nathancharlesjones/STM32F103C8T6-breakout-board/Supporting-documentation/STM32F103C8T6-breakout-board_power-section-graphic.pdf

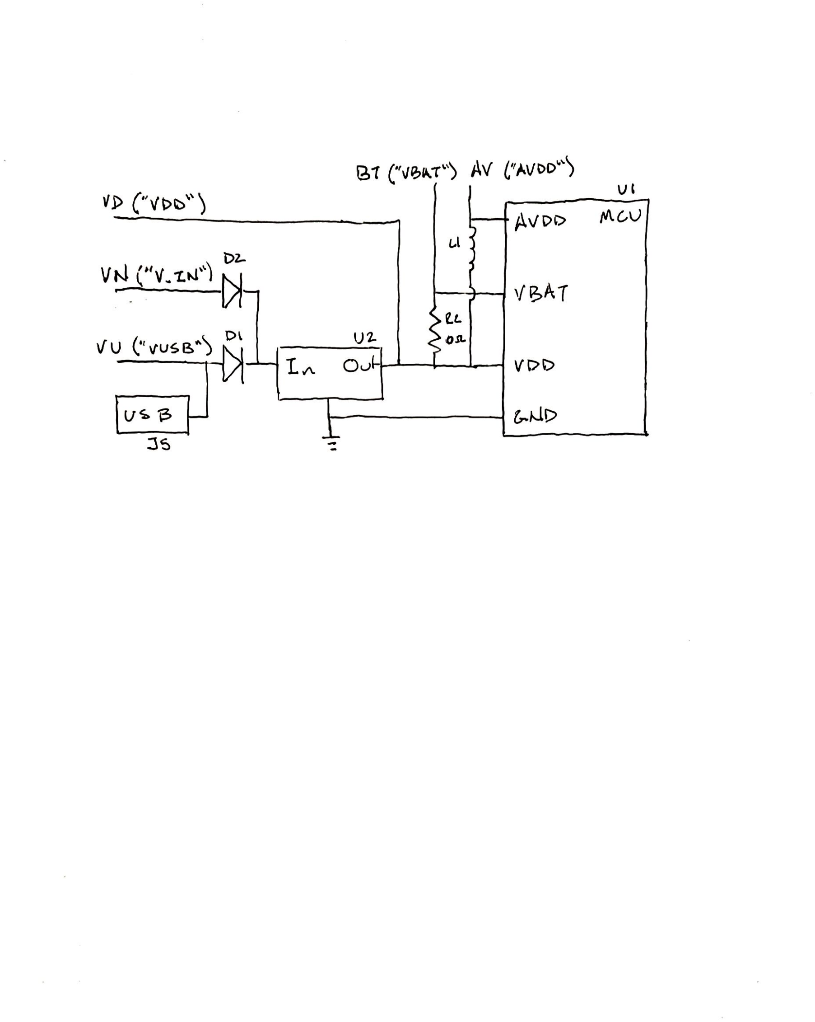
[picture p3: page 1]

B7 ("VBA7") AV ("AVDOWS
VD (“VDO")
UI
MCU
AVDD
LI
D2
VN ("V. IN“)
VBAT
.22
DI
OS
VU ("VUSB S
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
