nathancharlesjones/STM32F103C8T6-breakout-board/Supporting-documentation/Configuration-price-comparison-with-various-qty.xlsx

Sheet: Configurations
 | Minimum F031 | Minimum F302 | Minimum F103 | Standard F031 | Standard F302 | Standard F103 | Full F031 | Full F302 | Full F103
PCB | $5.00 | $5.00 | $5.00 | $5.00 | $5.00 | $5.00 | $5.00 | $5.00 | $5.00
Setup | $7.00 | $7.00 | $7.00 | $7.00 | $7.00 | $7.00 | $7.00 | $7.00 | $7.00
Stencil | $1.50 | $1.50 | $1.50 | $1.50 | $1.50 | $1.50 | $1.50 | $1.50 | $1.50
MCU | $9.73 | $30.02 | $56.21 | $9.73 | $30.02 | $56.21 | $9.73 | $30.02 | $56.21
MCU extended | $3.00 | $3.00 | $0.00 | $3.00 | $3.00 | $0.00 | $3.00 | $3.00 | $0.00
Other components | $2.32 | $2.32 | $2.32 | $10.57 | $10.58 | $10.58 | $15.29 | $15.29 | $15.30
Other extended | $3.00 | $3.00 | $3.00 | $6.00 | $6.00 | $6.00 | $9.00 | $9.00 | $9.00
Assembly | $1.60 | $1.60 | $1.60 | $2.12 | $2.12 | $2.12 | $2.10 | $2.10 | $2.10
Sum | $33.15 | $53.44 | $76.63 | $44.92 | $65.22 | $88.41 | $52.62 | $72.91 | $96.11
Price/unit | $3.32 | $5.34 | $7.66 | $4.49 | $6.52 | $8.84 | $5.26 | $7.29 | $9.61
MCU | $1.27 | $3.30 | $5.62 | $1.27 | $3.30 | $5.62 | $1.27 | $3.30 | $5.62
Everything else | $2.04 | $2.04 | $2.04 | $3.22 | $3.22 | $3.22 | $3.99 | $3.99 | $3.99

Sheet: Minimum
 | Minimum F103, Qty: 10 | Minimum F103, Qty: 15 | Minimum F103, Qty: 20 | Minimum F103, Qty: 25 | Minimum F103, Qty: 30 | Minimum F103, Qty: 50
PCB | $5.00 | $5.50 | $6.00 | $6.50 | $7.00 | $12.30
Setup | $7.00 | $7.00 | $7.00 | $7.00 | $7.00 | $7.00
Stencil | $1.50 | $1.50 | $1.50 | $1.50 | $1.50 | $1.50
MCU | $56.21 | $84.21 | $112.28 | $140.34 | $151.45 | $252.42
MCU extended | $0.00 | $0.00 | $0.00 | $0.00 | $0.00 | $0.00
Other components | $2.32 | $2.56 | $3.01 | $3.46 | $3.91 | $6.13
Other extended | $3.00 | $3.00 | $3.00 | $3.00 | $3.00 | $3.00
Assembly | $1.60 | $2.08 | $2.62 | $3.16 | $3.70 | $6.04
Sum | $76.63 | $105.85 | $135.41 | $164.96 | $177.56 | $288.39
Price/unit | $7.66 | $7.06 | $6.77 | $6.60 | $5.92 | $5.77
MCU | $5.62 | $5.61 | $5.61 | $5.61 | $5.05 | $5.05
Everything else | $2.04 | $1.44 | $1.16 | $0.98 | $0.87 | $0.72

Sheet: Standard_no_HSE
 | Standard F103, Qty: 10 | Standard F103, Qty: 15 | Standard F103, Qty: 20 | Standard F103, Qty: 25 | Standard F103, Qty: 30 | Standard F103, Qty: 50
PCB | $5.00 | $5.50 | $6.00 | $6.50 | $7.00 | $12.30
Setup | $7.00 | $7.00 | $7.00 | $7.00 | $7.00 | $7.00
Stencil | $1.50 | $1.50 | $1.50 | $1.50 | $1.50 | $1.50
MCU | $56.14 | $84.21 | $112.28 | $140.34 | $151.45 | $252.42
MCU extended | $0.00 | $0.00 | $0.00 | $0.00 | $0.00 | $0.00
Other components | $4.62 | $5.82 | $7.41 | $9.00 | $10.61 | $17.15
Other extended | $3.00 | $3.00 | $3.00 | $3.00 | $3.00 | $3.00
Assembly | $1.91 | $2.46 | $3.13 | $3.81 | $4.48 | $7.30
Sum | $79.17 | $109.49 | $140.32 | $171.16 | $185.04 | $300.67
Price/unit | $7.92 | $7.30 | $7.02 | $6.85 | $6.17 | $6.01
MCU | $5.61 | $5.61 | $5.61 | $5.61 | $5.05 | $5.05
Everything else | $2.30 | $1.69 | $1.40 | $1.23 | $1.12 | $0.97

Sheet: Standard_with_HSE
 | Standard F103, Qty: 10 | Standard F103, Qty: 15 | Standard F103, Qty: 20 | Standard F103, Qty: 25 | Standard F103, Qty: 30 | Standard F103, Qty: 50
PCB | $5.00 | $5.50 | $6.00 | $6.50 | $7.00 | $12.30
Setup | $7.00 | $7.00 | $7.00 | $7.00 | $7.00 | $7.00
Stencil | $1.50 | $1.50 | $1.50 | $1.50 | $1.50 | $1.50
MCU | $56.21 | $84.21 | $112.28 | $140.34 | $151.45 | $252.42
MCU extended | $0.00 | $0.00 | $0.00 | $0.00 | $0.00 | $0.00
Other components | $10.58 | $14.45 | $18.73 | $23.02 | $22.78 | $37.17
Other extended | $6.00 | $6.00 | $6.00 | $6.00 | $6.00 | $6.00
Assembly | $2.12 | $2.72 | $3.44 | $4.16 | $4.88 | $7.94
Sum | $88.41 | $121.38 | $154.95 | $188.52 | $200.61 | $324.33
Price/unit | $8.84 | $8.09 | $7.75 | $7.54 | $6.69 | $6.49
MCU | $5.62 | $5.61 | $5.61 | $5.61 | $5.05 | $5.05
Everything else | $3.22 | $2.48 | $2.13 | $1.93 | $1.64 | $1.44

Sheet: Full
 | Standard F103, Qty: 10 | Standard F103, Qty: 15 | Standard F103, Qty: 20 | Standard F103, Qty: 25 | Standard F103, Qty: 30 | Standard F103, Qty: 50
PCB | $5.00 | $5.50 | $6.00 | $6.50 | $7.00 | $12.30
Setup | $7.00 | $7.00 | $7.00 | $7.00 | $7.00 | $7.00
Stencil | $1.50 | $1.50 | $1.50 | $1.50 | $1.50 | $1.50
MCU | $56.21 | $84.21 | $112.28 | $140.34 | $151.45 | $252.42
MCU extended | $0.00 | $0.00 | $0.00 | $0.00 | $0.00 | $0.00
Other components | $15.30 | $21.33 | $27.78 | $34.22 | $32.51 | $53.18
Other extended | $9.00 | $9.00 | $9.00 | $9.00 | $9.00 | $9.00
Assembly | $2.10 | $2.74 | $3.50 | $4.27 | $5.03 | $8.21
Sum | $96.11 | $131.28 | $167.06 | $202.84 | $213.49 | $343.61
Price/unit | $9.61 | $8.75 | $8.35 | $8.11 | $7.12 | $6.87
MCU | $5.62 | $5.61 | $5.61 | $5.61 | $5.05 | $5.05
Everything else | $3.99 | $3.14 | $2.74 | $2.50 | $2.07 | $1.82
