nathancharlesjones/STM32F103C8T6-breakout-board/Supporting-documentation/_todo.md

# v1

- [x] What's the pinout for the J-Link connector? -> Not compatible with 20-pin JTAG
  - [x] Is SWD reset connected to NRST or JTRST? -> NRST
    - Pin 10 on 10-pin connector (nRST) is the same as Pin 15 on 20-pin connector (RST or nSRST) and connects to NRST on STM32 (pin 7)
    - Pin 9 on 10-pin connector (NC) is the same as Pin 3 on 20-pin connector (TRST) and connects to JTRST on STM32 (PB4; pin 40)
    - Compare Figure 12 in Hardware Guide with Segger [6-pin](https://www.segger.com/products/debug-probes/j-link/accessories/adapters/6-pin-needle-adapter/) and [10-pin adapters](https://www.segger.com/products/debug-probes/j-link/accessories/adapters/10-pin-needle-adapter/)
    - See also the Tag Connect [TC2050-ARM2010 ARM 20-pin to TC2050 Adapter datasheet](https://www.tag-connect.com/wp-content/uploads/bsk-pdf-manager/TC2050-ARM2010_18.pdf)
- [x] Tie VDDA to VDD?
- [x] Pick new 32kHz osc -> LCSC part #C32346
- [x] Check "Blue Pill" schematic
  - [x] Compare oscillator circuit
    - HSE
      - [x] Change C1/C2 to 30 pF
      - [x] What's R_EXT? Change to 663R?
    - LSE
      - [x] Change C1/C2 to 15 pF
    - [x] Check oscillator circuits
  - [x] Compare reset circuit -> Check for 100nF capacitance
  - [x] Check USB circuit -> Add 1.5K PU resistor on DP line (see AN4879)
- [x] Add USB connector
- [x] Finish adding power capacitors
- [x] Compare SWD connector to SOICBites/Debug Edge -> Use Debug Edge
  - Option 1: Normal 10-pin connector
    - ~$0.50/unit
    - Large footprint (200 x 500 mil)
  - Option 2: Right-angle 10-pin connector
    - ~$0.50/unit
    - Small footprint (150 x 250 mil)
    - Connector should be placed on PCB edge, with no other connectors for another 125 mil on either side
  - Option 3: SOICBites
    - $15 (one-time cost)
    - Small footprint
    - Must be placed on PCB edge; requires overhang
    - Requires hacking the SOIC connector and somehow connecting it to the J-Link
  - Option 4: Debug edge
    - ~$5 (one-time cost)
    - Large footprint (200 x 400 mil)
    - Must be placed on PCB edge; requires overhang
    - Requires building my own adapter board
    - May require building my own Eagle part (Octopart seems to be missing board outline)
    - Chamfering recommended (but possibly [not available from JLCPCB on boards <5cmx5cm](https://jlcpcb.com/quote/pcbOrderFaq/Gold%20Fingers)), though not required (according to Scott/@tannewt)
- [x] Add JLCPCB rules
- [x] Switch to 0402 resistors/capacitors
- [x] Add .gitignore
- [x] Add VUSB
  - Regulator power not needed if powering the MCU from VIN_2.0-3.6V
  - USB and VIN_5-30V need to be diode-protected, since I (may) want to have both connected at the same time. Doesn't matter which is higher, since they're both getting regulated down to 3.3V.
  - Change "VIN_2.0-3.6V" to "VDD"
  - Remove D1/D2 and install jumper; allows developer to decide whether to power the MCU from the "VDD" pin or from the regulator
  - Add "VUSB"; allows developer to power other parts of their circuit from USB.
- [x] Change 0R resistors to cut pads? -> Nah, at $0.002/resistor, it's actually easier to put down a 0R resistor than to ask someone to cut a trace
- [x] Add notch for Debug Edge
- [x] Change voltage regulator
- [x] Change Debug edge pins
- [x] Add LCSC part numbers to components
- [x] Add sections and numbers to schematic
- [x] Finish silkscreen
  - [x] Update component numbers
  - [x] Double check URL
- [x] Change crystals for oscillators
  - [x] Use wider voltage range? -> Nah
- [x] Add folder for special library parts: AVX, USB
- [x] New power arrangement?
- [x] Check USB lines
  - [x] Length match
- [x] Check edge alignment of USB connector/Debug-edge
- [x] Extend Debug edge indentation? -> Nah
- [x] Check hardware layout for STM32F302CBT6
  - [x] Other possibilities: STM32L151C8T6, STM32L052C8T6
- [x] Update LCSC part number for U1 on schematic
- [x] Order
  - [x] Include Q2?
- [x] Update README
  - [x] Get PCB screenshots
- [x] Add R4/6 to CPL
- [x] Check that extra components on CPL are just ignored
- [x] Reduce CPL files to one
- [x] Add Debug Edge README to 6P repo
- [x] Fix clearance issue
  - [x] Update protoboard as well
- [ ] Test!
  - [x] ST-Link
  - [x] J-link
  - [x] Debug Edge
  - [x] Bootloader, J5
  - [x] Bootloader, "USB breakout", Female headers
  - [ ] USB serial, J5
  - [ ] USB serial, "USB breakout", Female headers
- [x] Double-check pin-compatible MCUs (CubeMX lies!!!)
- [x] Update protoboard
  - [x] Add new design block
  - [x] Move J5/J3
  - [x] Check silkscreen
  - [x] Update images
- [x] Double-check compact board rules and silkscreen text
- [x] Find new 3.3V/5V regulators (higher input voltage)?
- [x] Order
  - [x] Follow up with JLCPCB about slotted holes
- [x] Make pinout diagram
- [x] Make power configuration diagram
- [x] Update bom/cpl files
- [x] Add ordering notes (polarity, slot, slotted holes)
- [x] Add editing notes (custom parts)
- [x] Update libraries folder
- [x] Add design block
- [x] Reword the "What is it?" section
- [x] Add ToC
- [x] Add "0R" to R2 in power section graphic
- [x] Change 0402 to tighter 0402
- [x] Check if 1.0mm slot will work
- [x] Update slot to 1.0mm? -> Not unless I have to. Wiggle room is 0mm under worst-case conditions.
- [x] Update things with new gerbers
  - [x] Take new screenshots
    - [x] Top screenshot
    - [x] Bottom screenshot
    - [x] Flip bottom screenshot
  - [x] Add 1.0mm slot to Debug Edge library
  - [x] Update design block
  - [x] Update schematic image
    - [x] Get new PDF
    - [x] Convert PDF to PNG
- [x] Add xls pin compatible list
- [x] Check parts with MOQ > 10
- [x] Add notes to JLCPCB pin compatible list
- [x] Update list of recommended alternatives
- [x] Edit pin compatible section (should say: here are the pin compatible MCUs that are available on JLC PCB, add $2 to the Qty:10 price to get the cost per board for a minimum configuration, etc)
- [x] Update prices (MCUs, assembly)
- [x] Rename spreadsheets
- [x] Possible to make spreadsheets viewable in Git? -> No, but [this tool](https://tabletomarkdown.com/convert-spreadsheet-to-markdown/) handily converts Excel tables into Markdown tables
- [x] Check pin-compatibility for:
  - [x] GD32E230C8T6
  - [x] GD32F130C6T6
  - [x] GD32E231C8T6
  - [x] GD32F130C8T6
  - [x] GD32F330C6T6
  - [x] GD32F330C8T6
  - [x] GD32F330CBT6
  - [x] GD32F150C6T6
  - [x] GD32F150C8T6
  - [x] GD32F350C6T6
  - [x] GD32F350C8T6
  - [x] GD32E103CBT6
  - [x] GD32F101CBT6
  - [x] GD32E103C8T6
  - [x] GD32F350CBT6
  - [x] GD32F190C8T6
  - [x] GD32F303CCT6
  - [x] GD32F103CBT6
- [x] Change "Standard" to "Standard_with-USB" and "Standard_no-USB" (or change all to "no-Vreg", "with_Vreg", with-HSE-OSC", "with-HSE-and-LSE-OSC"?)
  - [x] Remove R1
- [x] Change spreadsheet to use lookups
- [x] Add note about how to update spreadsheet with most recent list of JLC PCB inventory
- [x] Check cost of resistors/capacitors
- [x] Add note about ordering in qty 50/100
  - [x] Merge spreadsheets?
  - [x] Add qty prices for Standard, no HSE, and Full
  - [x] Update configuration notes for Standard, no HSE, and Full
- [x] Add note about GigaDevice development
- [x] Check links

# v2

- [ ] Add footprint for battery clip on bottom of PCB?
- [ ] Add trace/jumper on USB DP/DM to prevent USB signals from interferring with GPIO?
