nathancharlesjones/STM32F103C8T6-breakout-board/Supporting-documentation/STM32F103C8T6-breakout-board_schematic.pdf

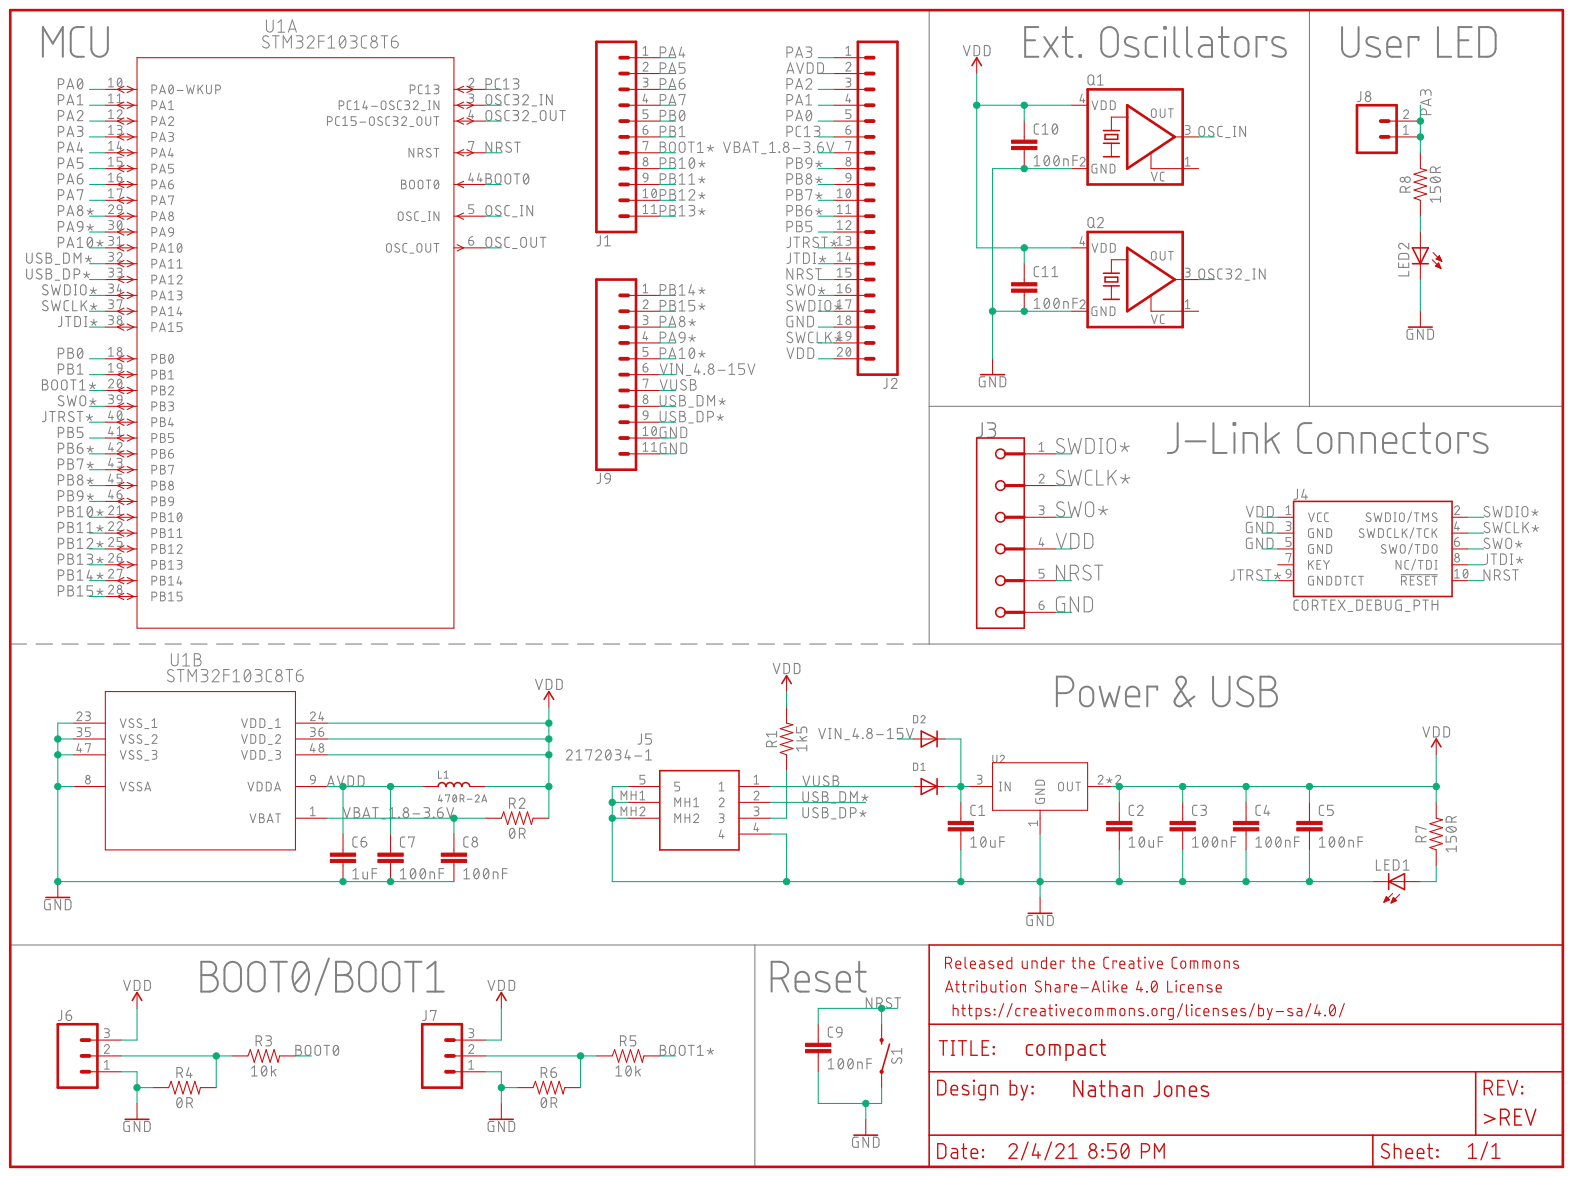
[picture p4: page 1]
