nathancharlesjones/STM32F103C8T6-breakout-board/(commit log)

2020-12-31 Added compact breakout board submodule. Added initial README.
2021-01-02 Updated submodules. Added libraries, References, and Pin-Compatibility-Check folders.
    [Pin-compatible-comparison.ods]
2021-01-03 Updated README.
    [Pin-compatible-comparison.ods]
2021-01-30 Updated link to compact repo. Updated schematic.
2021-01-31 Updated power section.
2021-01-31 Updated power section graphic.
2021-02-02 Finished pin compatibility spreadsheet. Updated README.
    [Pin-compatibility-notes_LQFP48.ods]
2021-02-14 Updated README.
    Added spreadsheet comparing "MOQ" for each part. Added qty information.
    [Price-comparison.ods]
2021-02-15 Updated price per qty information
    [Price-comparison.ods]
2021-02-15 Update STM32F103C8T6-breakout-board_compact
2021-02-16 Updated pin compatibility
    Moved datasheets and two crucial price and pin compatibility spreadsheets. Deleted pin compatibility folder. Upgraded price comparison spreadsheet to use lookups.
    [Configuration-price-comparison-with-various-qty.xlsx, Pin-compatibility-notes_LQFP48.ods, Pin-compatibility-notes_LQFP48.xlsx, Pin-compatible-MCUs-in-JLCPCB-inventory.ods, Pin-compatible-comparison.ods, Price-comparison.ods]
2021-02-28 Pulled changes to compact which include a mini-USB connector instead of a micro-B.
2021-03-05 Updated schematic.
